nils-van-zuijlen/splitflap/Page de confirmation.pdf

Protection vie privée

Copyright © 2023 - Tous droits réservés

SITE PARTICULIERS RS COMPONENTS

Date de la transaction :
22 juin 2023

Numéro de carte :
5341##########95

Référence de la transaction : 231105

Identifiant de la commande : 284375

Identifiant du commerçant : 033453403900035

Cas de paiement :
Paiement unique

Montant de la transaction : 64,21 €

Numéro d’autorisation :
630402

Informations sur la transaction
