nils-van-zuijlen/splitflap/pcb/moduleDriver/moduleDriver.kicad_pcb

## KiCad design pcb/moduleDriver/moduleDriver.kicad_pcb (2024-06-09)

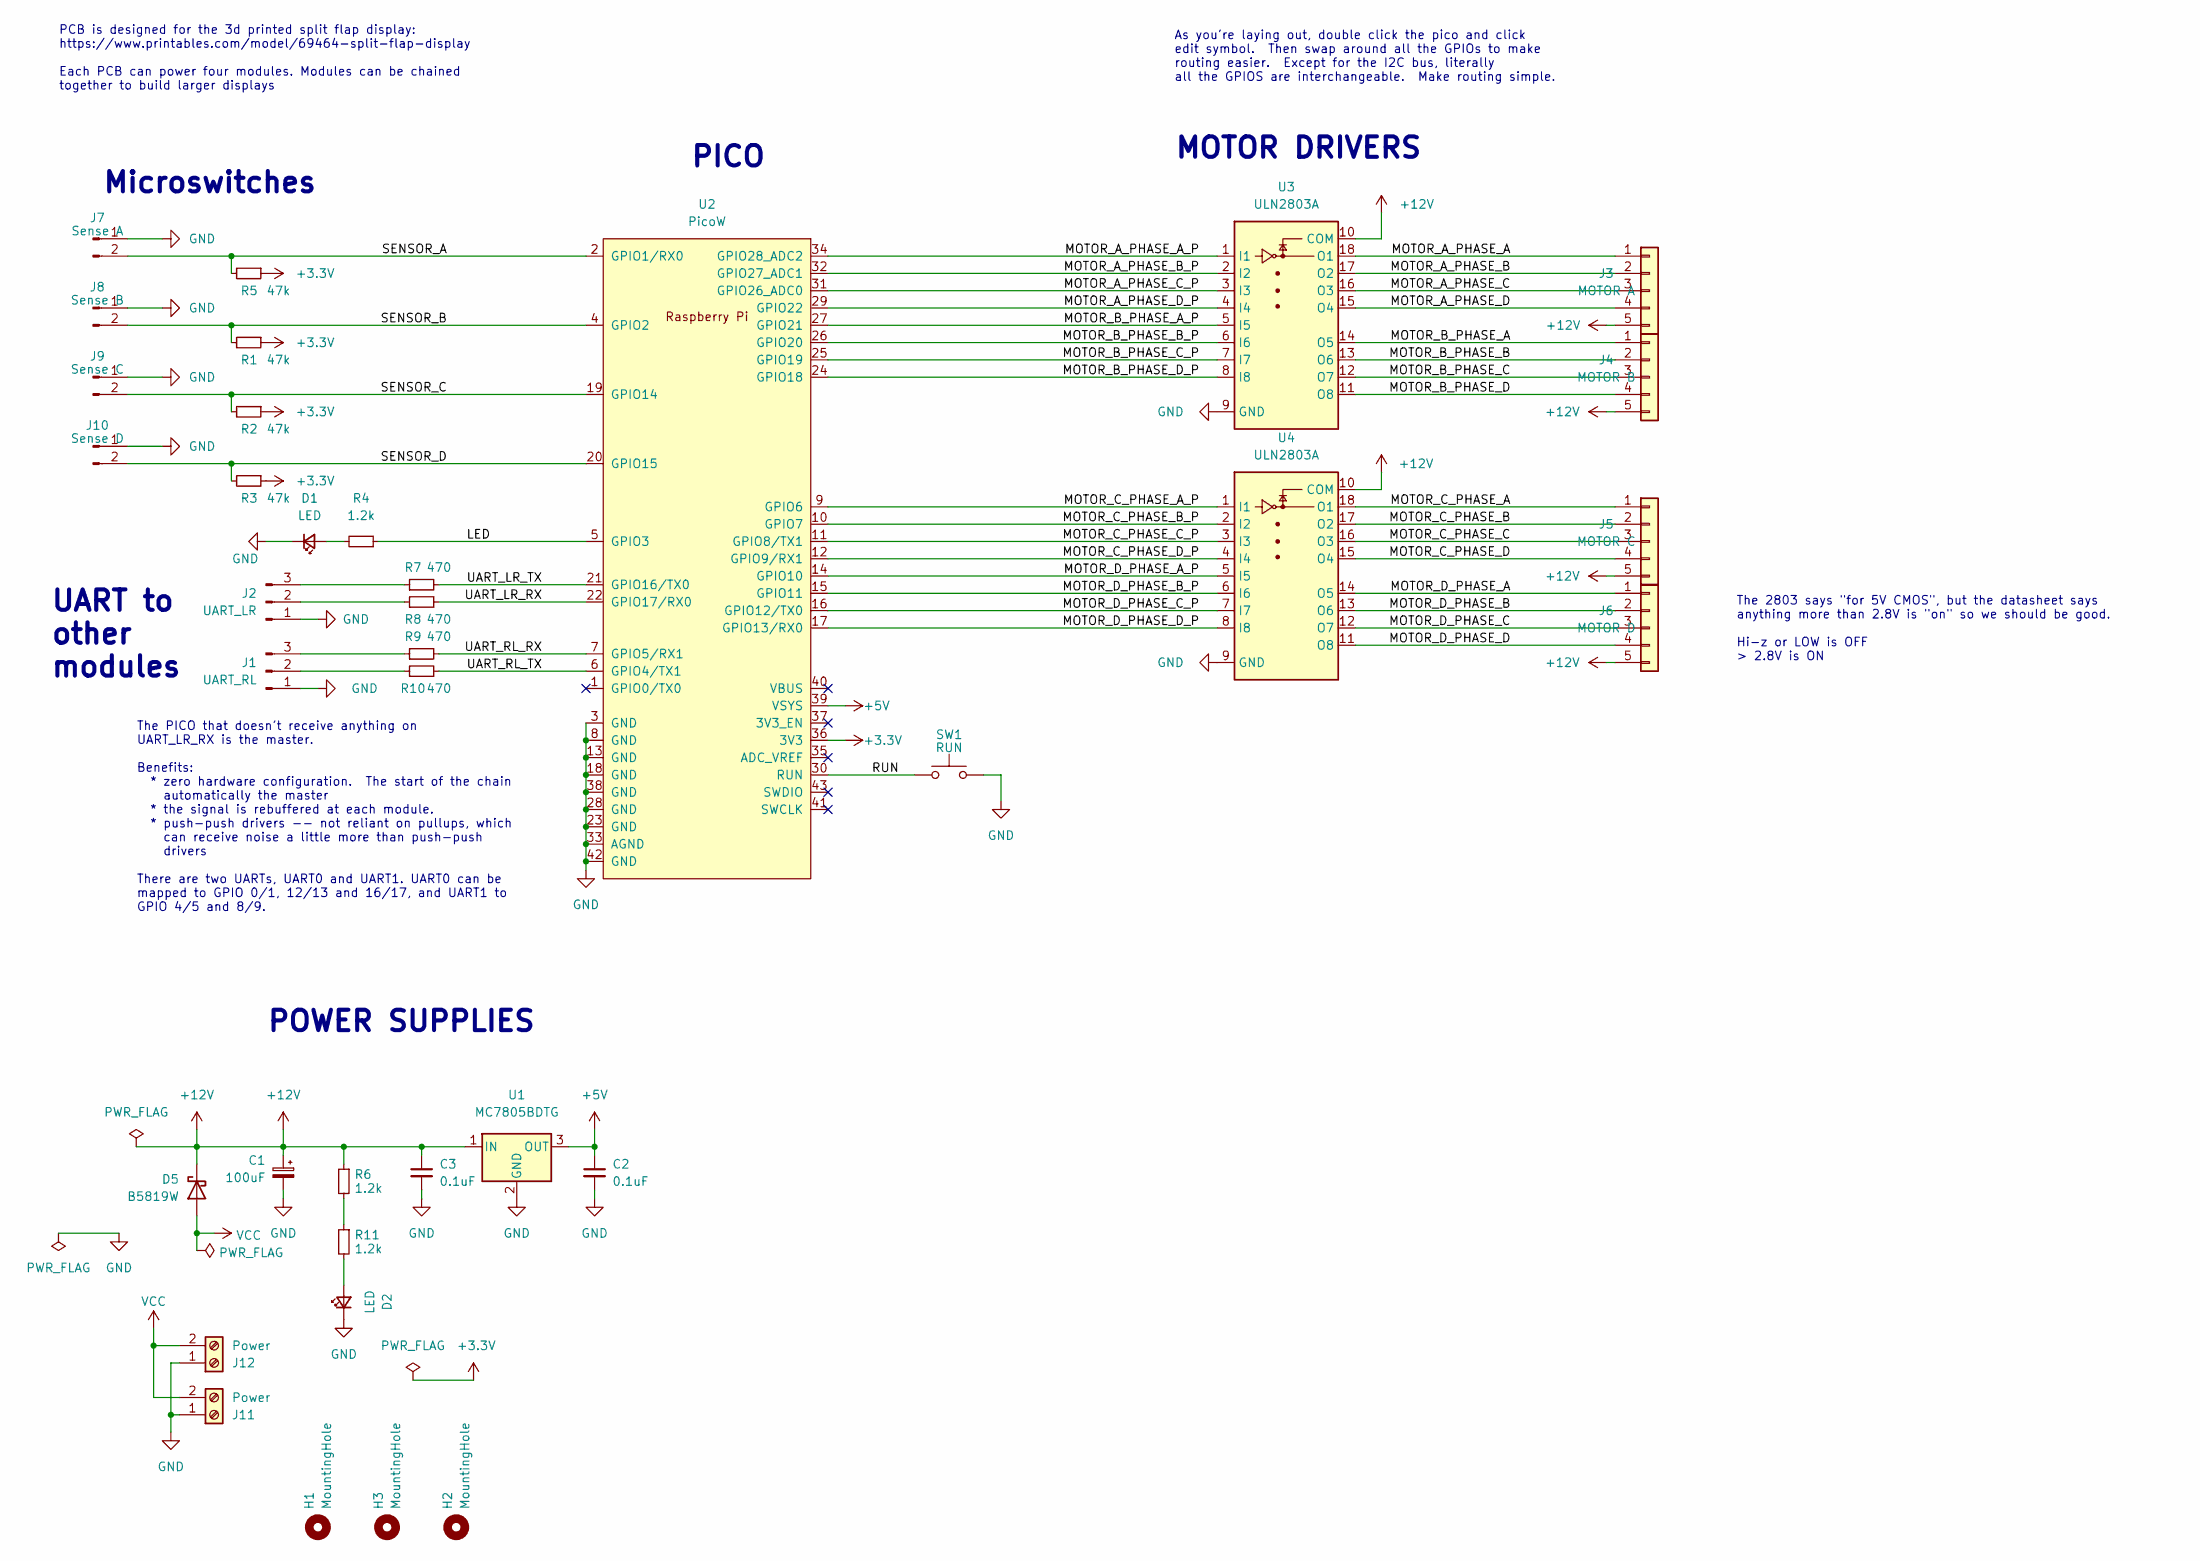
[picture p1: schematic moduleDriver.kicad_sch, Split Flap Module]

Parts:
C1: 100uF; CP_Elec_8x10; LCSC# C176665
C2, C3: 0.1uF; C_1206_3216Metric; LCSC# C14663
D1, D2: LED; LED_1206_3216Metric; LCSC# C72041
D5: B5819W; D_SOD-123; LCSC# C8598
H1, H2, H3: MountingHole; MountingHole_3.2mm_M3_ISO7380
J1: UART_RL; JST_XH_B3B-XH-A_1x03_P2.50mm_Vertical
J2: UART_LR; JST_XH_B3B-XH-A_1x03_P2.50mm_Vertical
J3: MOTOR A; JST_XH_B5B-XH-A_1x05_P2.50mm_Vertical
J4: MOTOR B; JST_XH_B5B-XH-A_1x05_P2.50mm_Vertical
J5: MOTOR C; JST_XH_B5B-XH-A_1x05_P2.50mm_Vertical
J6: MOTOR D; JST_XH_B5B-XH-A_1x05_P2.50mm_Vertical
J7: Sense A; JST_XH_B2B-XH-A_1x02_P2.50mm_Vertical
J8: Sense B; JST_XH_B2B-XH-A_1x02_P2.50mm_Vertical
J9: Sense C; JST_XH_B2B-XH-A_1x02_P2.50mm_Vertical
J10: Sense D; JST_XH_B2B-XH-A_1x02_P2.50mm_Vertical
J11, J12: Power; PhoenixContact_MSTBA_2,5_2-G_1x02_P5.00mm_Horizontal
R1, R2, R3, R5: 47k; R_1206_3216Metric; LCSC# C25819
R4, R6, R11: 1.2k; R_1206_3216Metric; LCSC# C22765
R7, R8, R9, R10: 470; R_1206_3216Metric; LCSC# C23179
SW1: RUN; SW_PUSH_6mm
U1: MC7805BDTG; TO-252-2; LCSC# C83632
U2: PicoW; RPi_PicoW_SMD_TH
U3, U4: ULN2803A; DIP-18_W7.62mm_Socket; LCSC# C181731

Connections:
+3.3V: R1.1, R2.1, R3.1, R5.1, U2.36 (3V3)
+5V: C2.1, U1.3 (OUT), U2.39 (VSYS)
+12V: C1.1, C3.1, D5.1 (K), J3.5, J4.5, J5.5, J6.5, R6.1, U1.1 (IN), U3.10 (COM), U4.10 (COM)
/LED: R4.1, U2.5 (GPIO3)
/MOTOR_A_PHASE_A: J3.1, U3.18 (O1)
/MOTOR_A_PHASE_A_P: U2.34 (GPIO28_ADC2), U3.1 (I1)
/MOTOR_A_PHASE_B: J3.2, U3.17 (O2)
/MOTOR_A_PHASE_B_P: U2.32 (GPIO27_ADC1), U3.2 (I2)
/MOTOR_A_PHASE_C: J3.3, U3.16 (O3)
/MOTOR_A_PHASE_C_P: U2.31 (GPIO26_ADC0), U3.3 (I3)
/MOTOR_A_PHASE_D: J3.4, U3.15 (O4)
/MOTOR_A_PHASE_D_P: U2.29 (GPIO22), U3.4 (I4)
/MOTOR_B_PHASE_A: J4.1, U3.14 (O5)
/MOTOR_B_PHASE_A_P: U2.27 (GPIO21), U3.5 (I5)
/MOTOR_B_PHASE_B: J4.2, U3.13 (O6)
/MOTOR_B_PHASE_B_P: U2.26 (GPIO20), U3.6 (I6)
/MOTOR_B_PHASE_C: J4.3, U3.12 (O7)
/MOTOR_B_PHASE_C_P: U2.25 (GPIO19), U3.7 (I7)
/MOTOR_B_PHASE_D: J4.4, U3.11 (O8)
/MOTOR_B_PHASE_D_P: U2.24 (GPIO18), U3.8 (I8)
/MOTOR_C_PHASE_A: J5.1, U4.18 (O1)
/MOTOR_C_PHASE_A_P: U2.9 (GPIO6), U4.1 (I1)
/MOTOR_C_PHASE_B: J5.2, U4.17 (O2)
/MOTOR_C_PHASE_B_P: U2.10 (GPIO7), U4.2 (I2)
/MOTOR_C_PHASE_C: J5.3, U4.16 (O3)
/MOTOR_C_PHASE_C_P: U2.11 (GPIO8/TX1), U4.3 (I3)
/MOTOR_C_PHASE_D: J5.4, U4.15 (O4)
/MOTOR_C_PHASE_D_P: U2.12 (GPIO9/RX1), U4.4 (I4)
/MOTOR_D_PHASE_A: J6.1, U4.14 (O5)
/MOTOR_D_PHASE_A_P: U2.14 (GPIO10), U4.5 (I5)
/MOTOR_D_PHASE_B: J6.2, U4.13 (O6)
/MOTOR_D_PHASE_B_P: U2.15 (GPIO11), U4.6 (I6)
/MOTOR_D_PHASE_C: J6.3, U4.12 (O7)
/MOTOR_D_PHASE_C_P: U2.16 (GPIO12/TX0), U4.7 (I7)
/MOTOR_D_PHASE_D: J6.4, U4.11 (O8)
/MOTOR_D_PHASE_D_P: U2.17 (GPIO13/RX0), U4.8 (I8)
/RUN: SW1.1, U2.30 (RUN)
/SENSOR_A: J7.2, R5.2, U2.2 (GPIO1/RX0)
/SENSOR_B: J8.2, R1.2, U2.4 (GPIO2)
/SENSOR_C: J9.2, R2.2, U2.19 (GPIO14)
/SENSOR_D: J10.2, R3.2, U2.20 (GPIO15)
/UART_LR_RX: R8.2, U2.22 (GPIO17/RX0)
/UART_LR_TX: R7.2, U2.21 (GPIO16/TX0)
/UART_RL_RX: R9.2, U2.7 (GPIO5/RX1)
/UART_RL_TX: R10.2, U2.6 (GPIO4/TX1)
GND: C1.2, C2.2, C3.2, D1.1 (K), D2.1 (K), J1.1, J2.1, J7.1, J8.1, J9.1, J10.1, J11.1, J12.1, SW1.2, U1.2 (GND), U2.3 (GND), U2.8 (GND), U2.13 (GND), U2.18 (GND), U2.23 (GND), U2.28 (GND), U2.33 (AGND), U2.38 (GND), U2.42 (GND), U3.9 (GND), U4.9 (GND)
unnamed: D1.2 (A), R4.2
unnamed: D2.2 (A), R11.2
unnamed: J1.2, R10.1
unnamed: J1.3, R9.1
unnamed: J2.2, R8.1
unnamed: J2.3, R7.1
unnamed: R6.2, R11.1
VCC: D5.2 (A), J11.2, J12.2

Notes on the sheet:
The 2803 says "for 5V CMOS", but the datasheet says anything more than 2.8V is "on" so we should be good. Hi-z or LOW is OFF > 2.8V is ON
Microswitches
UART to other modules
MOTOR DRIVERS
PICO
As you're laying out, double click the pico and click edit symbol. Then swap around all the GPIOs to make routing easier. Except for the I2C bus, literally all the GPIOS are interchangeable. Make routing simple.
PCB is designed for the 3d printed split flap display: https://www.printables.com/model/69464-split-flap-display Each PCB can power four modules. Modules can be chained together to build larger displays
POWER SUPPLIES
The PICO that doesn't receive anything on UART_LR_RX is the master. Benefits: * zero hardware configuration. The start of the chain automatically the master * the signal is rebuffered at each module. * push-push drivers -- not reliant on pullups, which can receive noise a little more than push-push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

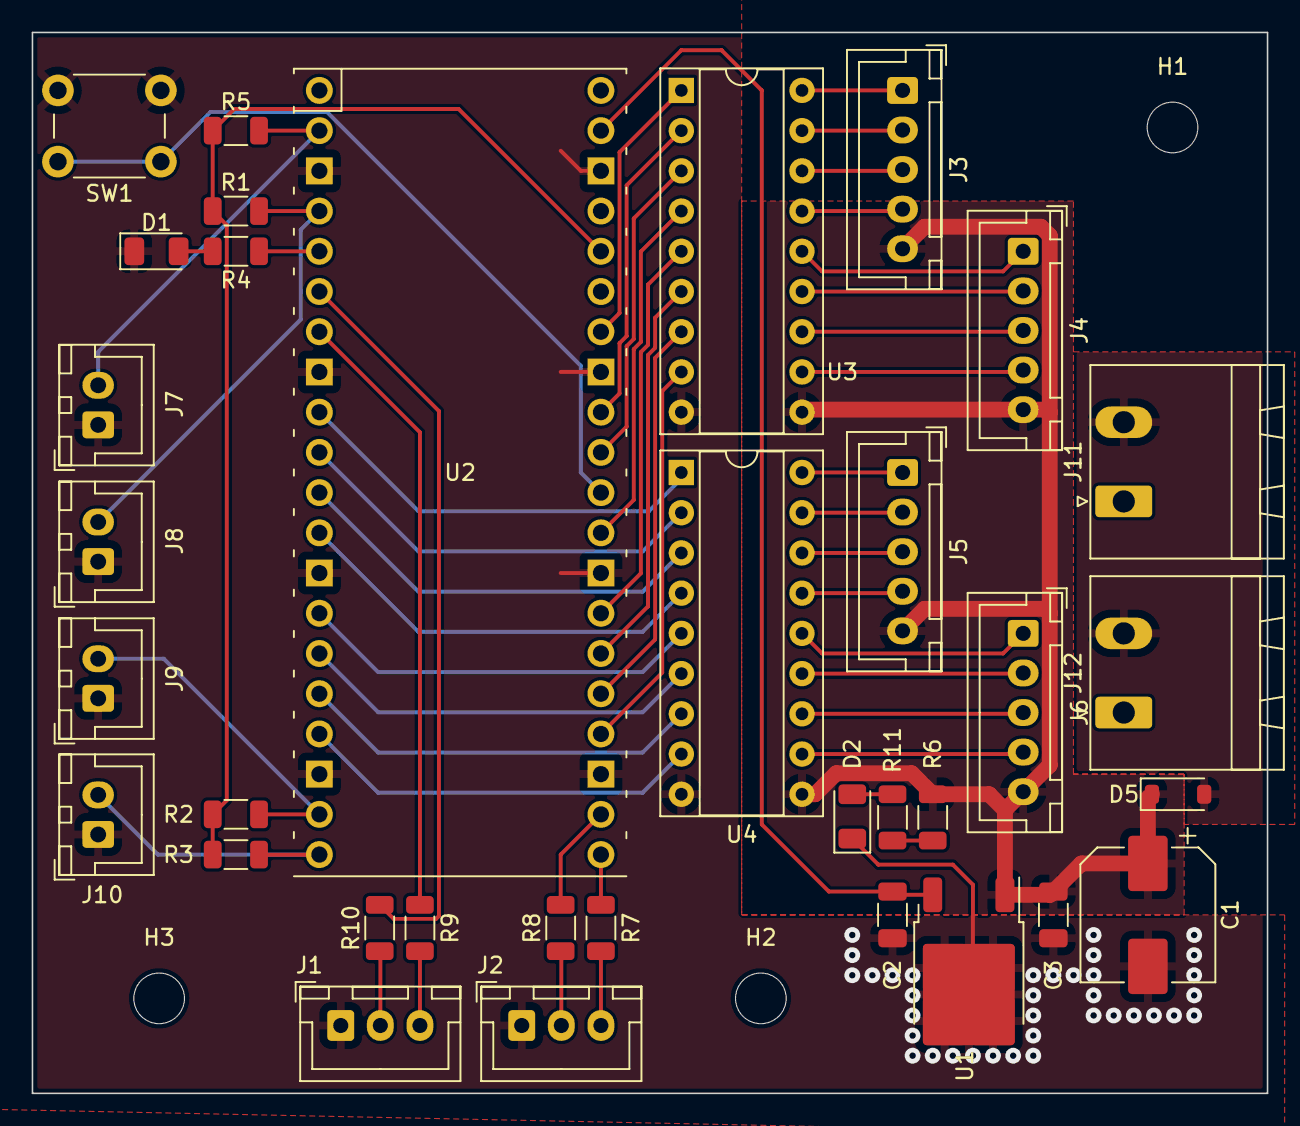
[picture p2: board moduleDriver.kicad_pcb from above]

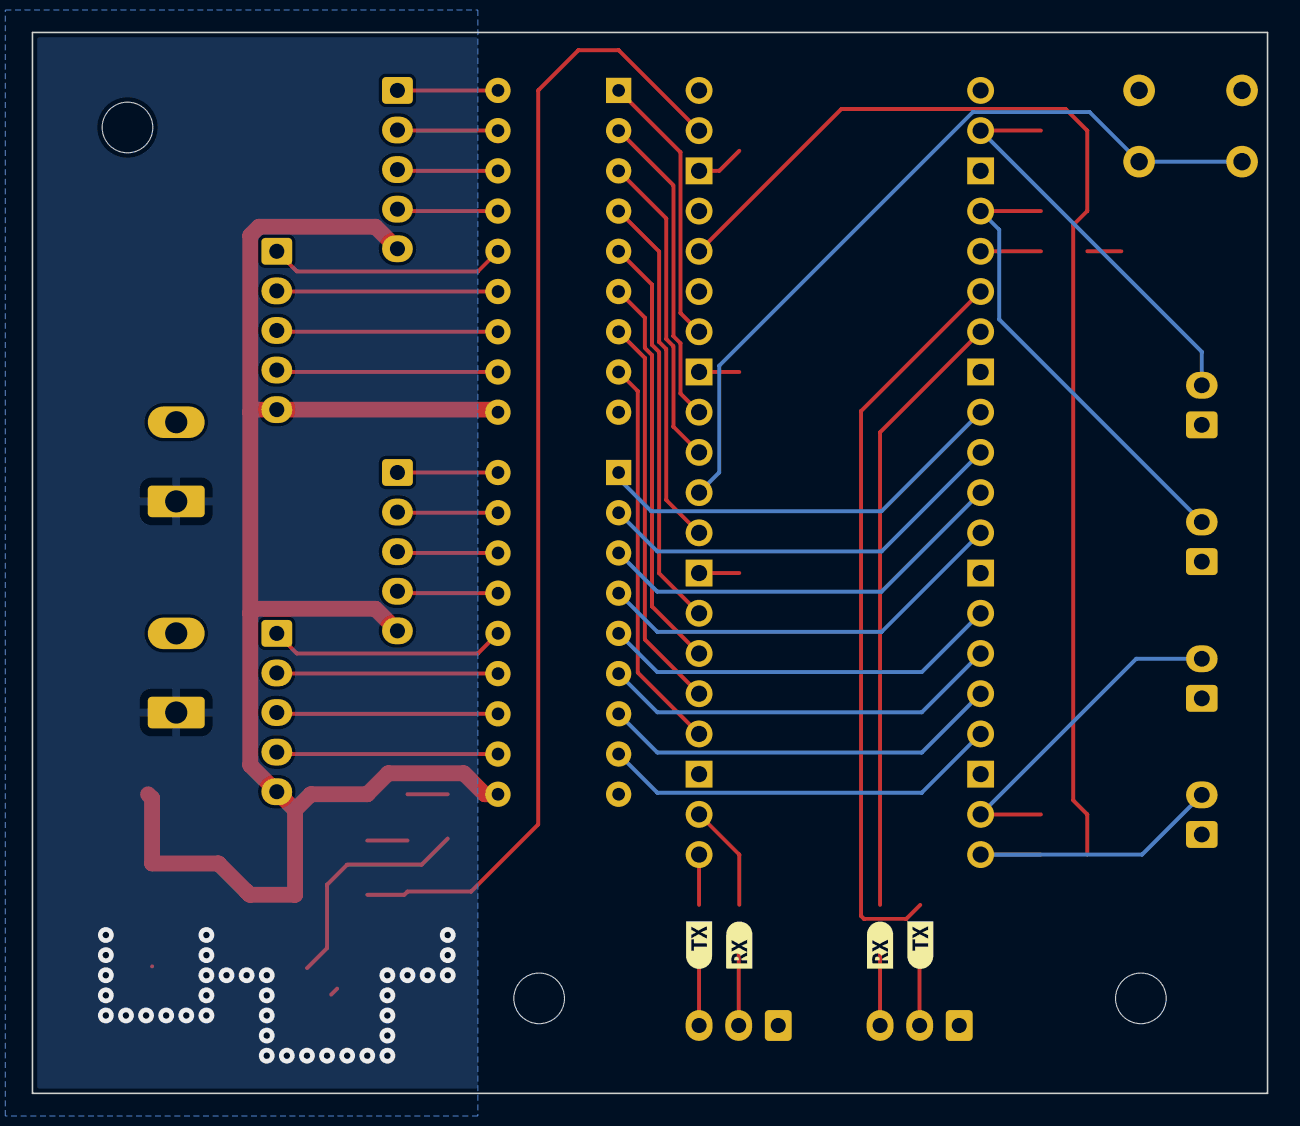
[picture p3: board moduleDriver.kicad_pcb from below]

Board: 2 copper layers, 78.0 x 67.0 mm, 41 parts (4 on the bottom side), 54 nets.

Other parts of the board:
kibuzzard-64922CB7, kibuzzard-64922CB7#2: G***; kibuzzard-64922CB7
kibuzzard-64922CEC, kibuzzard-64922CEC#2: G***; kibuzzard-64922CEC
