nils-van-zuijlen/splitflap/(commit log)

2024-06-09 Single thread
    [moduleDriver-B_Cu.gbl, moduleDriver-B_Mask.gbs, moduleDriver-B_Paste.gbp, moduleDriver-B_Silkscreen.gbo, moduleDriver-Edge_Cuts.gm1, moduleDriver-F_Cu.gtl, moduleDriver-F_Mask.gts, moduleDriver-F_Paste.gtp]
2024-06-09 Now with asynchronous reset
    [main.rs, module_logic.rs]
2024-06-09 Make UART transmission work
    [moduleDriver.kicad_pcb]
2024-06-09 Slow the reset down so that the switch has time to click
    [module_logic.rs]
2024-06-09 Add control Pico code
